TIShoueb/jnw_ex_sky130a/sim/JNW_EX/README.md

TB_NCM

### Transient analysis (tran)

Check transient operation

|**Name**|**Parameter**|**Description**| |**Min**|**Typ**|**Max**| Unit|
|:---|:---|:---|---:|:---:|:---:|:---:| ---:|
|**Output current**|**ibns\_20u** || **Spec**  | **16.000** | **20.000** | **24.000** | **uA** |
| | | |<a href='results/tran_Sch_typical.html'>Sch_typ</a>| | 20.592 |  | |
| | | |<a href='results/tran_Sch_etc.html'>Sch_etc</a>|20.469 | 20.600 | 20.728 | |
| | | |<a href='results/tran_Sch_mc.html'>Sch_3std</a>|18.072 | 20.693 | 23.315 | |
|**Gate-Source voltage**|**vgs\_m1** || **Spec**  | **0.300** | **0.600** | **0.700** | **V** |
| | | |<a href='results/tran_Sch_typical.html'>Sch_typ</a>| | 0.686 |  | |
| | | |<a href='results/tran_Sch_etc.html'>Sch_etc</a>|0.604 | 0.685 | <span style='color:red'>**0.758**</span> | |
| | | |<a href='results/tran_Sch_mc.html'>Sch_3std</a>|0.679 | 0.687 | 0.694 | |
