TIShoueb/jnw_ex_sky130a/sim/JNW_EX/results/tran_Sch_mc.md

### Summary tran_Sch_mc

For details see <a href='tran_Sch_mc.html'>tran_Sch_mc.html</a>

|**Name**|**Parameter**|**View**|**Min** | **Typ** | **Max**|
|:---|:---|:---:|:---:|:---:|:---:|
|Output current|ibns\_20u | Spec | 16.000 uA | 20.000 uA | 24.000 uA |
| | | ('Sch',)|19.140 uA | 20.629 uA | 22.541 uA |
|Gate-Source voltage|vgs\_m1 | Spec | 0.300 V | 0.600 V | 0.700 V |
| | | ('Sch',)|0.682 V | 0.687 V | 0.691 V |
