TIShoueb/jnw_ex_sky130a/sim/TB_JNW_GR03_LSTB/results/lstb_Sch_typical.html

| f3db | gm_db | lf_gain | pm_deg | ug | v(lpo) | v(xdut.vd1) | vdiff
count | 1.000 kHz | 1.00 dB | 1.00 dB | 1.00 | 1.00 MHz | 1.00 V | 1.00 V | 1.00 mV
mean | 174.843 kHz | -14.11 dB | 42.94 dB | 53.74 | 22.43 MHz | 0.81 V | 0.62 V | -0.53 mV
std | nan kHz | nan dB | nan dB | nan | nan MHz | nan V | nan V | nan mV
min | 174.843 kHz | -14.11 dB | 42.94 dB | 53.74 | 22.43 MHz | 0.81 V | 0.62 V | -0.53 mV
25% | 174.843 kHz | -14.11 dB | 42.94 dB | 53.74 | 22.43 MHz | 0.81 V | 0.62 V | -0.53 mV
50% | 174.843 kHz | -14.11 dB | 42.94 dB | 53.74 | 22.43 MHz | 0.81 V | 0.62 V | -0.53 mV
75% | 174.843 kHz | -14.11 dB | 42.94 dB | 53.74 | 22.43 MHz | 0.81 V | 0.62 V | -0.53 mV
max | 174.843 kHz | -14.11 dB | 42.94 dB | 53.74 | 22.43 MHz | 0.81 V | 0.62 V | -0.53 mV

f3db | gm_db | lf_gain | pm_deg | ug | v(lpo) | v(xdut.vd1) | vdiff | name | type | time | OK
174.843 kHz | -14.11 dB | 42.94 dB | 53.74 | 22.43 MHz | 0.81 V | 0.62 V | -0.53 mV | lstb_SchGtKttTtVt | Sch | Sun Mar 16 16:47:14 2025 | False
