TIShoueb/jnw_ex_sky130a/sim/JNW_EX/results/tran_Sch_etc.html

| ibns_20u | vgs_m1
count | 8.000 uA | 8.000 V
mean | 20.600 uA | 0.683 V
std | 0.104 uA | 0.055 V
min | 20.469 uA | 0.604 V
25% | 20.513 uA | 0.659 V
50% | 20.600 uA | 0.685 V
75% | 20.688 uA | 0.709 V
max | 20.728 uA | 0.758 V

ibns_20u | vgs_m1 | name | type | time | OK
20.469 uA | 0.758 V | tran_SchGtKfsTlVt | Sch | Sun Jan 19 19:36:31 2025 | False
20.681 uA | 0.685 V | tran_SchGtKsfTlVt | Sch | Sun Jan 19 19:36:31 2025 | True
20.657 uA | 0.695 V | tran_SchGtKffTlVt | Sch | Sun Jan 19 19:36:31 2025 | True
20.494 uA | 0.748 V | tran_SchGtKssTlVt | Sch | Sun Jan 19 19:36:31 2025 | False
20.519 uA | 0.684 V | tran_SchGtKfsThVt | Sch | Sun Jan 19 19:36:31 2025 | True
20.728 uA | 0.604 V | tran_SchGtKsfThVt | Sch | Sun Jan 19 19:36:31 2025 | True
20.706 uA | 0.614 V | tran_SchGtKffThVt | Sch | Sun Jan 19 19:36:31 2025 | True
20.542 uA | 0.674 V | tran_SchGtKssThVt | Sch | Sun Jan 19 19:36:31 2025 | True
