TIShoueb/jnw_ex_sky130a/sim/JNW_EX/results/tran_Sch_mc.html

| ibns_20u | vgs_m1
count | 30.000 uA | 30.000 V
mean | 20.693 uA | 0.687 V
std | 0.874 uA | 0.003 V
min | 19.140 uA | 0.682 V
25% | 20.157 uA | 0.685 V
50% | 20.629 uA | 0.687 V
75% | 21.210 uA | 0.689 V
max | 22.541 uA | 0.691 V

ibns_20u | vgs_m1 | name | type | time | OK
20.395 uA | 0.685 V | tran_SchGtKttmmTtVt_29 | Sch | Sun Jan 19 19:36:35 2025 | True
20.211 uA | 0.686 V | tran_SchGtKttmmTtVt_28 | Sch | Sun Jan 19 19:36:35 2025 | True
22.541 uA | 0.690 V | tran_SchGtKttmmTtVt_27 | Sch | Sun Jan 19 19:36:35 2025 | True
21.974 uA | 0.689 V | tran_SchGtKttmmTtVt_26 | Sch | Sun Jan 19 19:36:35 2025 | True
19.246 uA | 0.684 V | tran_SchGtKttmmTtVt_25 | Sch | Sun Jan 19 19:36:35 2025 | True
21.379 uA | 0.689 V | tran_SchGtKttmmTtVt_24 | Sch | Sun Jan 19 19:36:34 2025 | True
22.184 uA | 0.690 V | tran_SchGtKttmmTtVt_23 | Sch | Sun Jan 19 19:36:34 2025 | True
20.487 uA | 0.689 V | tran_SchGtKttmmTtVt_22 | Sch | Sun Jan 19 19:36:34 2025 | True
20.483 uA | 0.687 V | tran_SchGtKttmmTtVt_21 | Sch | Sun Jan 19 19:36:34 2025 | True
20.440 uA | 0.688 V | tran_SchGtKttmmTtVt_20 | Sch | Sun Jan 19 19:36:34 2025 | True
20.872 uA | 0.686 V | tran_SchGtKttmmTtVt_19 | Sch | Sun Jan 19 19:36:34 2025 | True
19.474 uA | 0.685 V | tran_SchGtKttmmTtVt_18 | Sch | Sun Jan 19 19:36:34 2025 | True
20.271 uA | 0.686 V | tran_SchGtKttmmTtVt_17 | Sch | Sun Jan 19 19:36:34 2025 | True
19.569 uA | 0.682 V | tran_SchGtKttmmTtVt_16 | Sch | Sun Jan 19 19:36:34 2025 | True
21.139 uA | 0.689 V | tran_SchGtKttmmTtVt_15 | Sch | Sun Jan 19 19:36:34 2025 | True
20.984 uA | 0.686 V | tran_SchGtKttmmTtVt_14 | Sch | Sun Jan 19 19:36:33 2025 | True
21.212 uA | 0.687 V | tran_SchGtKttmmTtVt_13 | Sch | Sun Jan 19 19:36:33 2025 | True
20.114 uA | 0.684 V | tran_SchGtKttmmTtVt_12 | Sch | Sun Jan 19 19:36:33 2025 | True
19.140 uA | 0.683 V | tran_SchGtKttmmTtVt_11 | Sch | Sun Jan 19 19:36:33 2025 | True
21.680 uA | 0.688 V | tran_SchGtKttmmTtVt_10 | Sch | Sun Jan 19 19:36:33 2025 | True
21.205 uA | 0.689 V | tran_SchGtKttmmTtVt_9 | Sch | Sun Jan 19 19:36:33 2025 | True
20.488 uA | 0.689 V | tran_SchGtKttmmTtVt_8 | Sch | Sun Jan 19 19:36:33 2025 | True
21.022 uA | 0.687 V | tran_SchGtKttmmTtVt_7 | Sch | Sun Jan 19 19:36:33 2025 | True
21.401 uA | 0.685 V | tran_SchGtKttmmTtVt_6 | Sch | Sun Jan 19 19:36:33 2025 | True
19.380 uA | 0.682 V | tran_SchGtKttmmTtVt_5 | Sch | Sun Jan 19 19:36:32 2025 | True
20.139 uA | 0.685 V | tran_SchGtKttmmTtVt_4 | Sch | Sun Jan 19 19:36:32 2025 | True
20.787 uA | 0.683 V | tran_SchGtKttmmTtVt_3 | Sch | Sun Jan 19 19:36:32 2025 | True
20.769 uA | 0.687 V | tran_SchGtKttmmTtVt_2 | Sch | Sun Jan 19 19:36:32 2025 | True
20.029 uA | 0.685 V | tran_SchGtKttmmTtVt_1 | Sch | Sun Jan 19 19:36:32 2025 | True
21.786 uA | 0.691 V | tran_SchGtKttmmTtVt | Sch | Sun Jan 19 19:36:32 2025 | True
