TIShoueb/jnw_ex_sky130a/sim/JNW_EX/results/tran_Sch_typical.csv

 | ibns_20u | vgs_m1 | name | type | time | OK
0 | 20.591730000000002 | 0.6859839 | tran_SchGtKttTtVt | Sch | Sun Jan 19 19:36:30 2025 | True
