TIShoueb/jnw_ex_sky130a/sim/TB_JNW_GR03_LSTB/results/lstb_Sch_typical.csv

 | f3db | gm_db | lf_gain | pm_deg | ug | v(lpo) | v(xdut.vd1) | vdiff | name | type | time | OK
0 | 174.8429 | -14.1054 | 42.94218 | 53.73855 | 22.42538 | 0.807774 | 0.6229541 | -0.5348930000000001 | lstb_SchGtKttTtVt | Sch | Sun Mar 16 16:47:14 2025 | False
