TIShoueb/jnw_ex_sky130a/(commit log)

2025-01-19 Made JNW_EX_SKY130A
    [JNW_EX.sch]
2025-01-19 i have changed something
    [JNW_EX.sch, tran_Sch_etc.csv, tran_Sch_mc.csv, tran_Sch_typical.csv]
2025-01-19 last update
    [tran_Sch_etc.csv, tran_Sch_mc.csv, tran_Sch_typical.csv]
